HelloThereMatey/mag_sputter_tool/auto_control/docs/pics/bulb_off.png

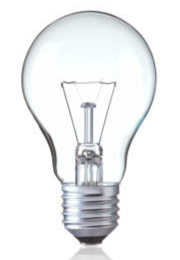
auto_control/docs/pics/bulb_off.png
