HelloThereMatey/mag_sputter_tool/auto_control/docs/pics/bulb_on.png

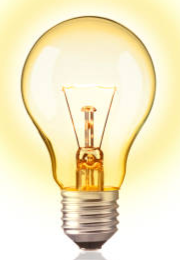
auto_control/docs/pics/bulb_on.png
