HelloThereMatey/mag_sputter_tool/auto_control/docs/pics/shutter.png

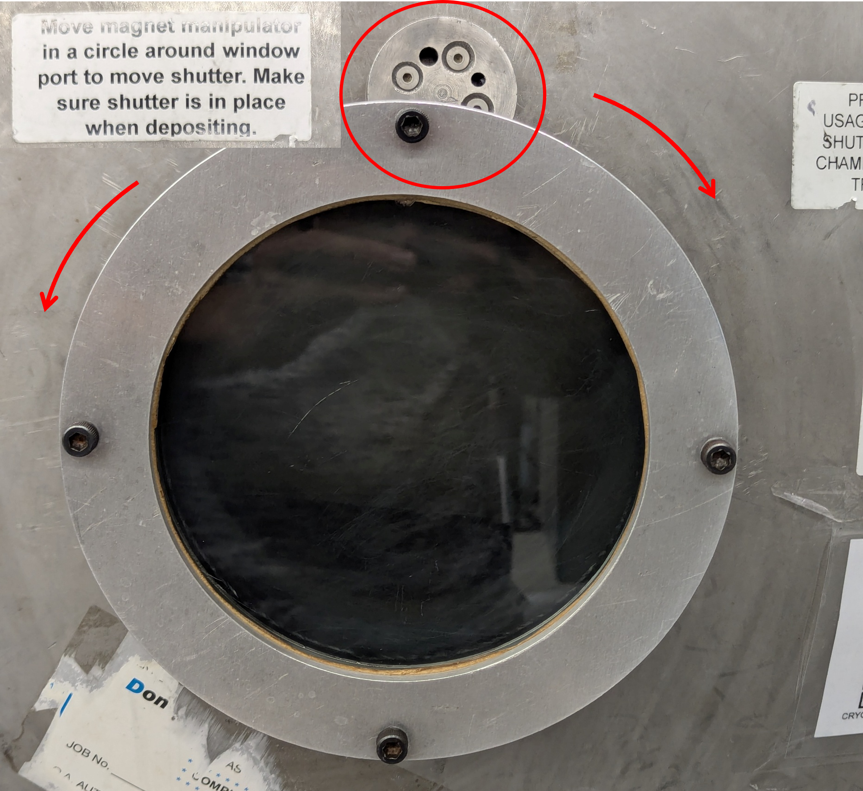
auto_control/docs/pics/shutter.png
