HelloThereMatey/mag_sputter_tool/launcher/sun.png

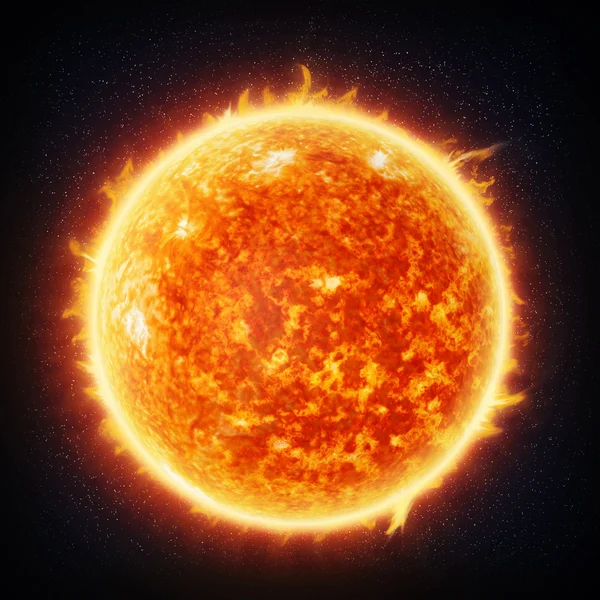
launcher/sun.png
