HelloThereMatey/mag_sputter_tool/pics/20251017_16h33m43s_grim.png

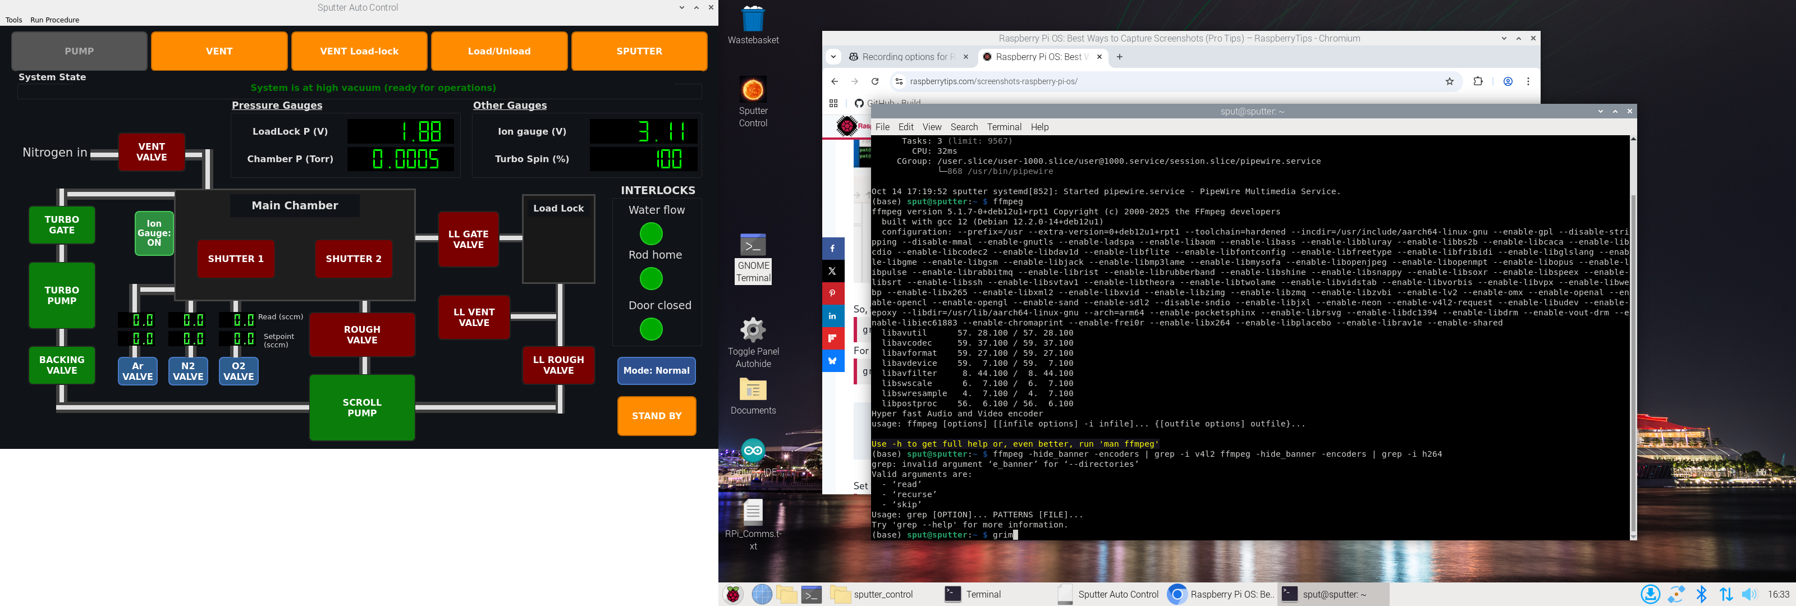
pics/20251017_16h33m43s_grim.png
