HelloThereMatey/mag_sputter_tool/pics/20251017_16h39m33s_grim.png

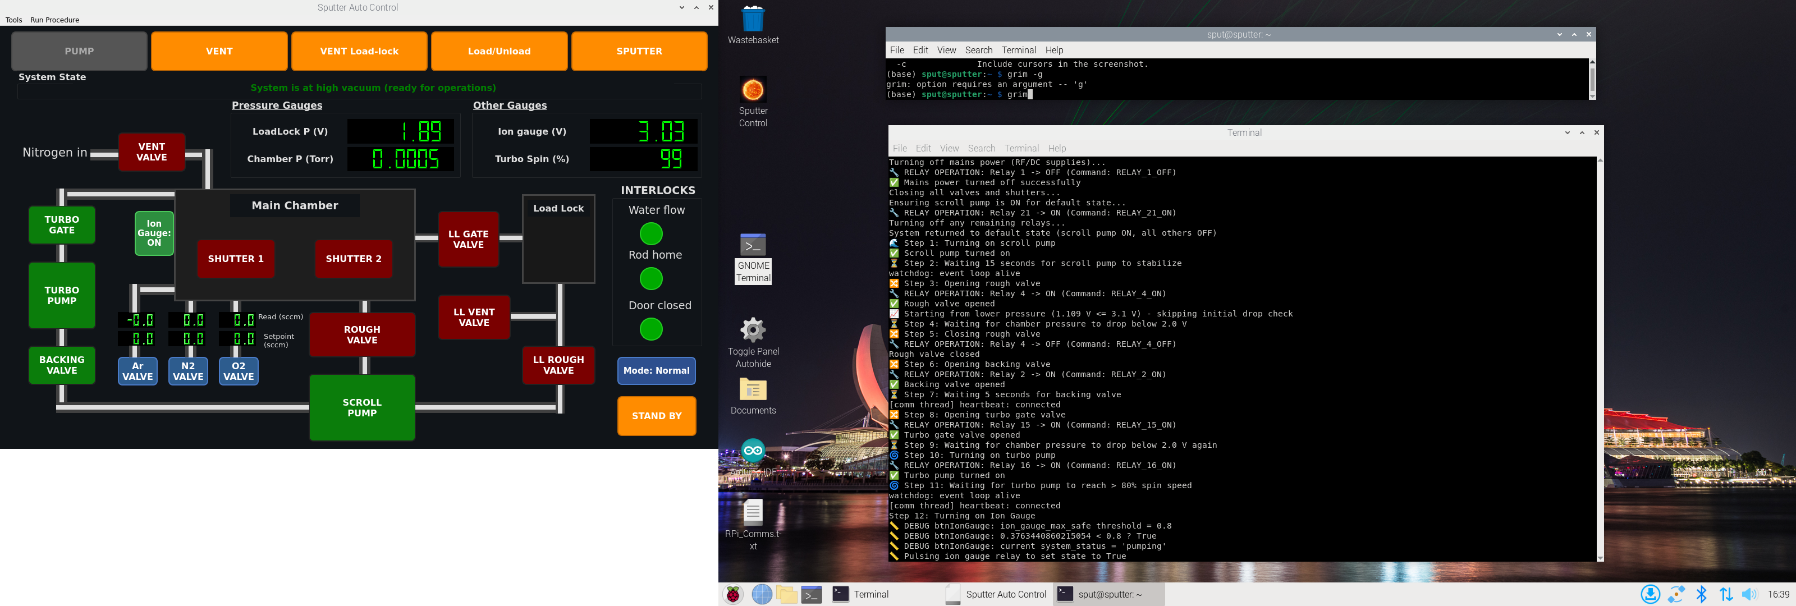
pics/20251017_16h39m33s_grim.png
