HelloThereMatey/mag_sputter_tool/pics/20251112_18h08m32s_grim.png

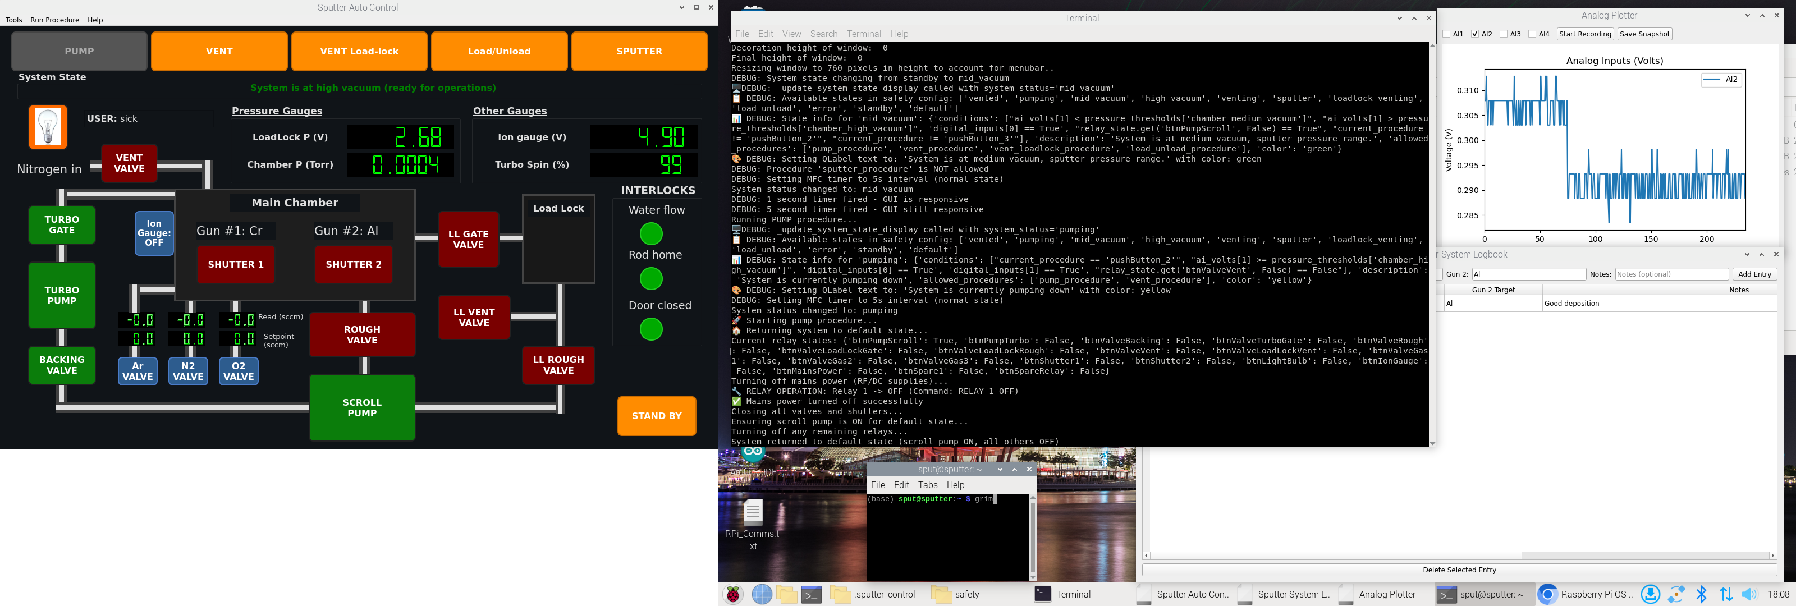
pics/20251112_18h08m32s_grim.png
