HelloThereMatey/mag_sputter_tool/pics/pump_water.jpg

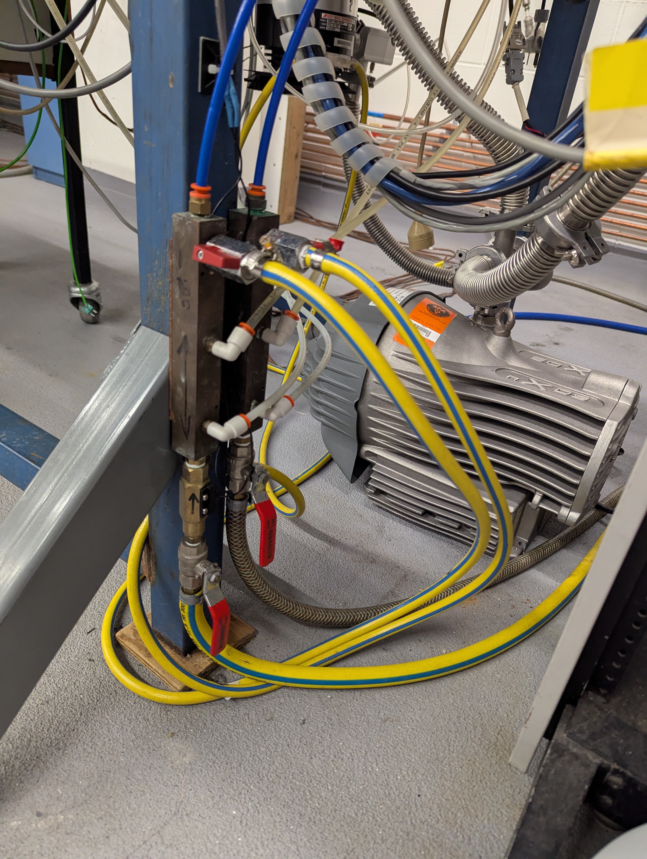
pics/pump_water.jpg
