HelloThereMatey/mag_sputter_tool/pics/pumpz.jpg

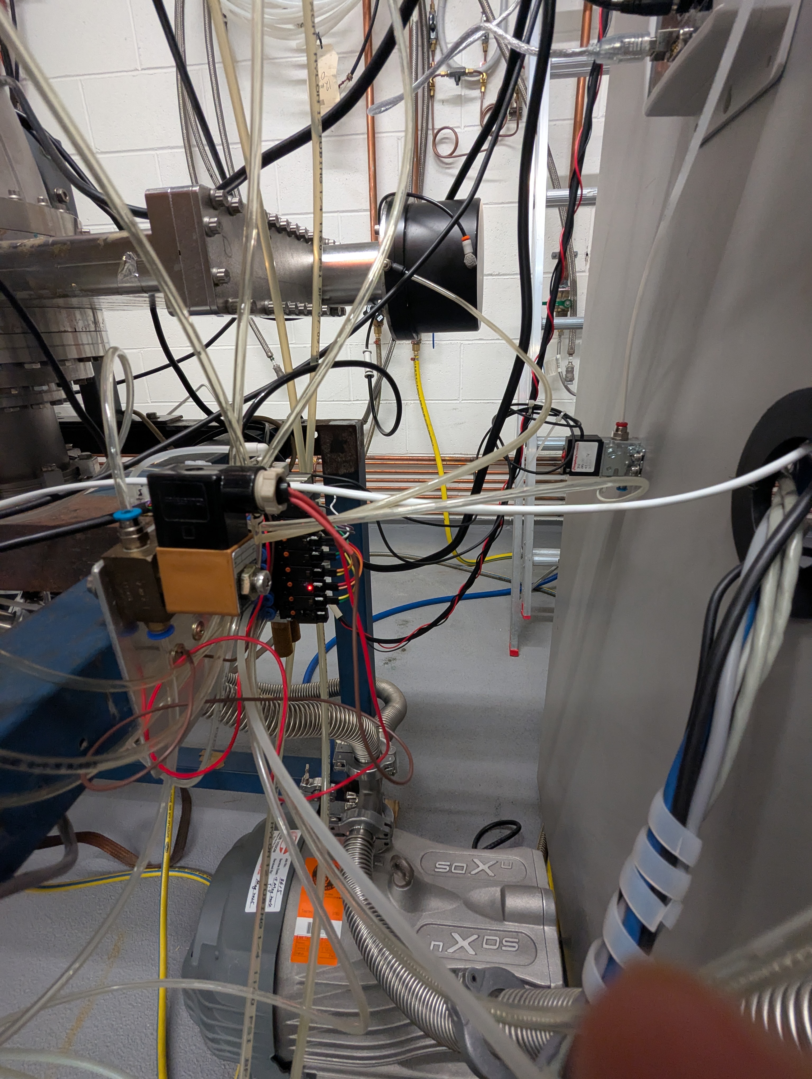
pics/pumpz.jpg
