HelloThereMatey/mag_sputter_tool/pics/PXL_20250912_063716222.jpg

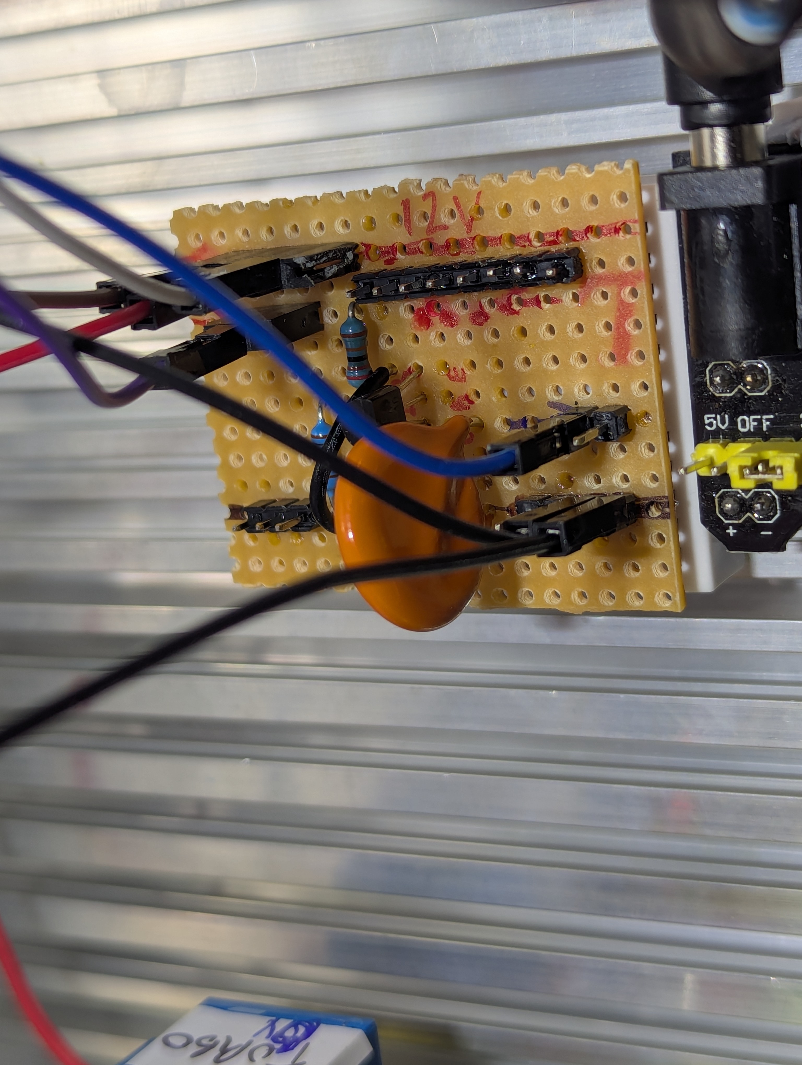
pics/PXL_20250912_063716222.jpg
