HelloThereMatey/mag_sputter_tool/pics/PXL_20250912_063729227.jpg

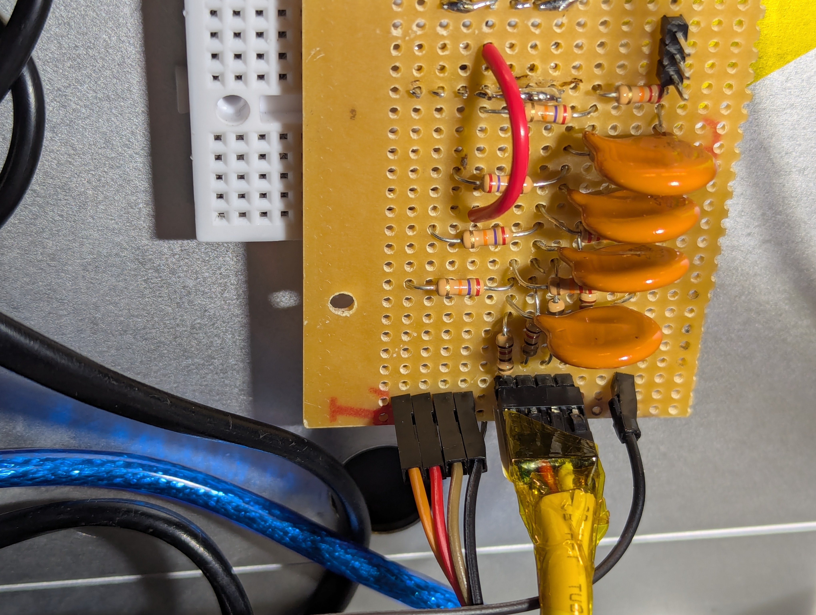
pics/PXL_20250912_063729227.jpg
