HelloThereMatey/mag_sputter_tool/pics/PXL_20251024_043526031.jpg

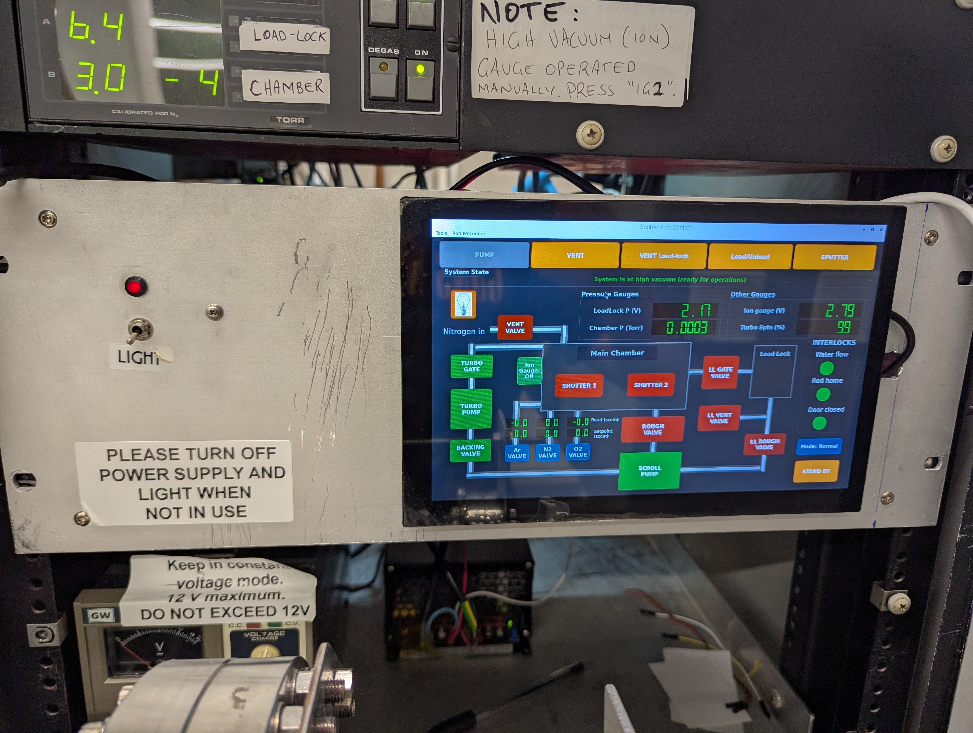
pics/PXL_20251024_043526031.jpg
