HelloThereMatey/mag_sputter_tool/pics/PXL_20251024_043535404.jpg

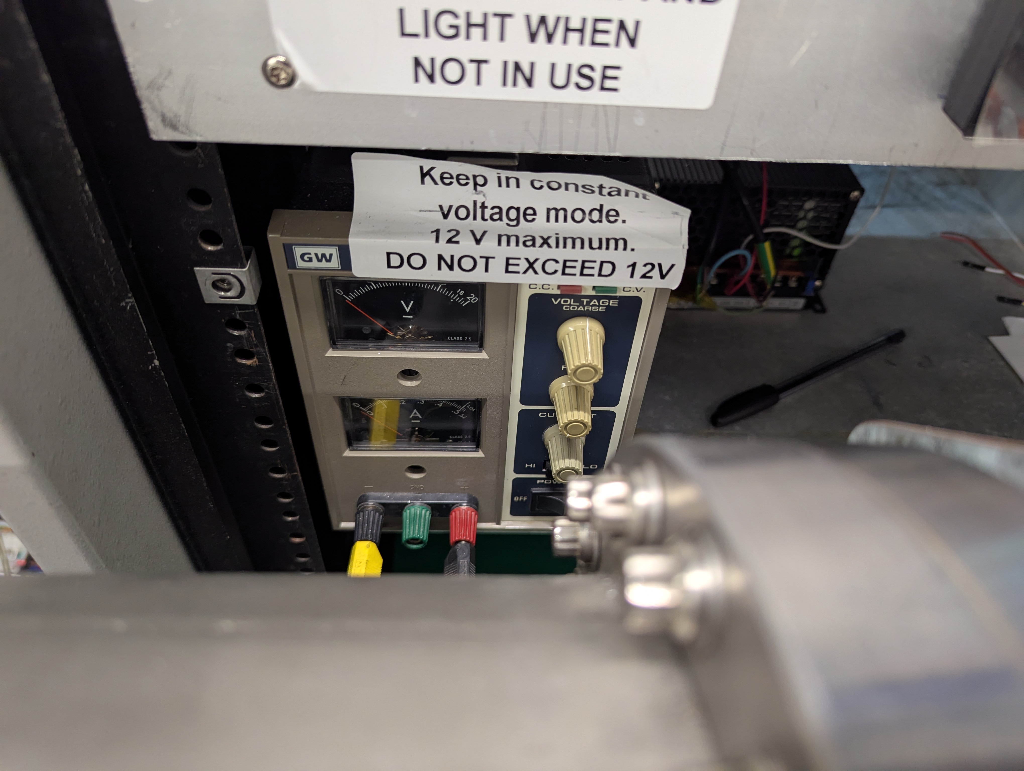
pics/PXL_20251024_043535404.jpg
