HelloThereMatey/mag_sputter_tool/pics/PXL_20251112_060554242.jpg

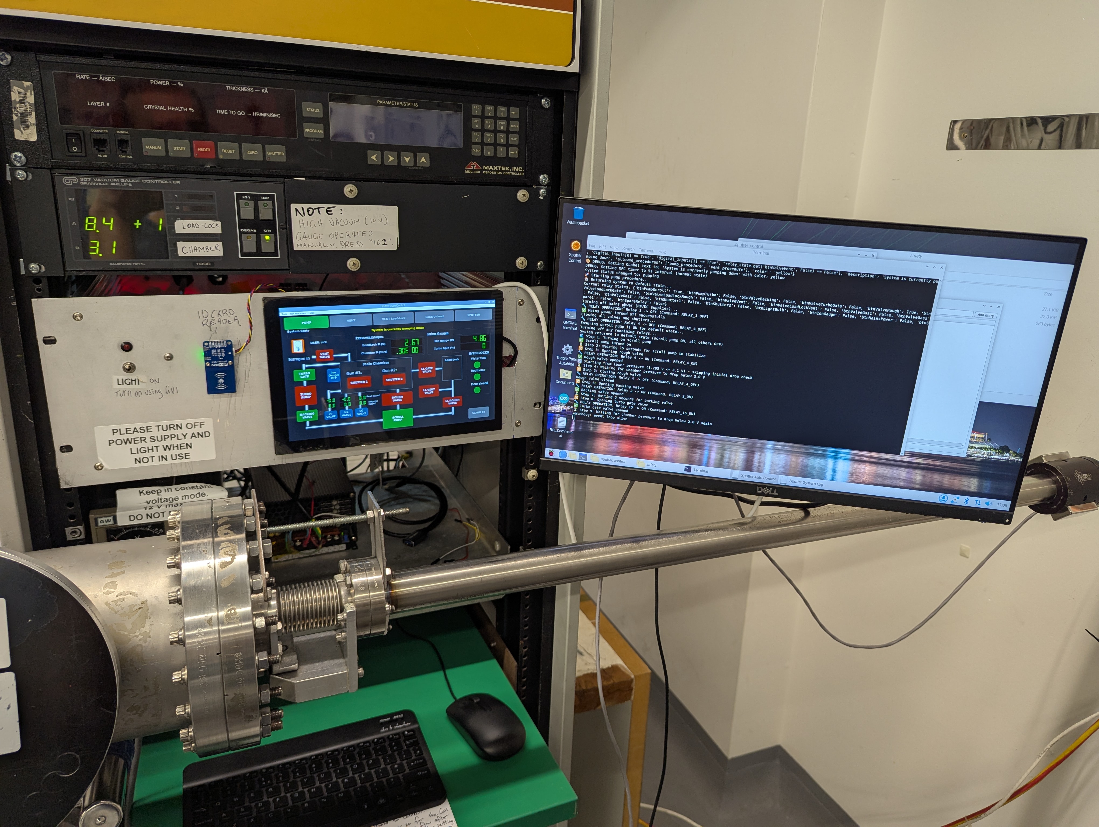
pics/PXL_20251112_060554242.jpg
