HelloThereMatey/mag_sputter_tool/pics/PXL_20251112_060644361.jpg

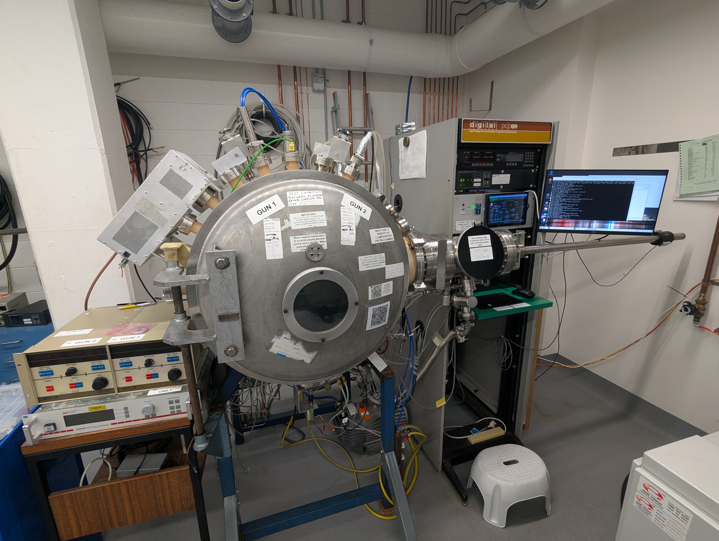
pics/PXL_20251112_060644361.jpg
