HelloThereMatey/mag_sputter_tool/pics/small/20251017_16h33m43s_grim.jpg

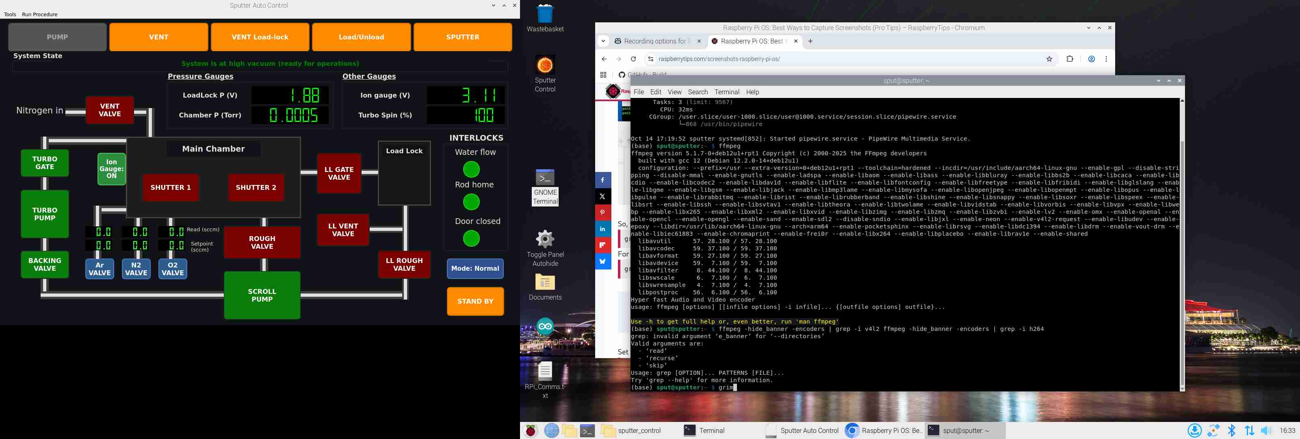
pics/small/20251017_16h33m43s_grim.jpg
