HelloThereMatey/mag_sputter_tool/pics/small/20251017_16h39m33s_grim.jpg

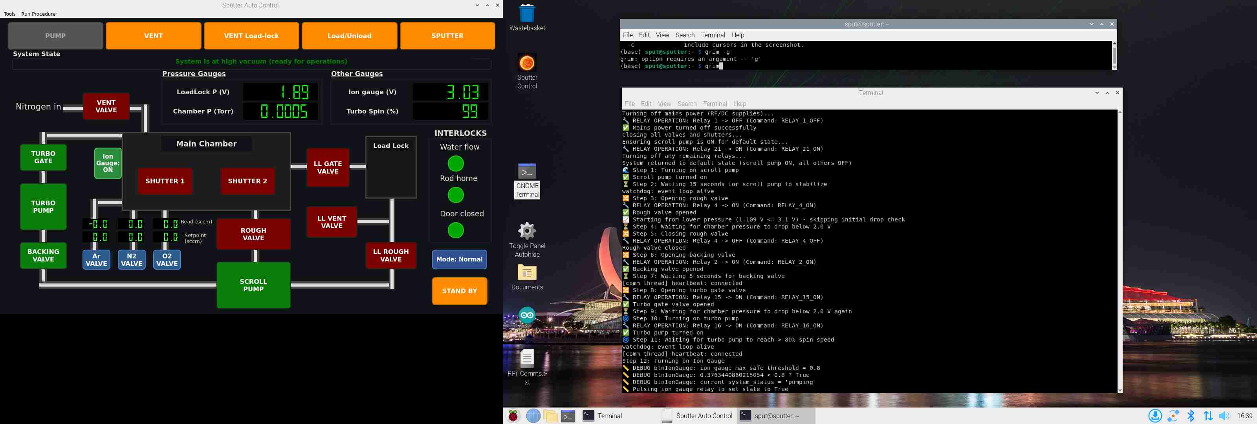
pics/small/20251017_16h39m33s_grim.jpg
