HelloThereMatey/mag_sputter_tool/pics/small/20251112_18h08m32s_grim.jpg

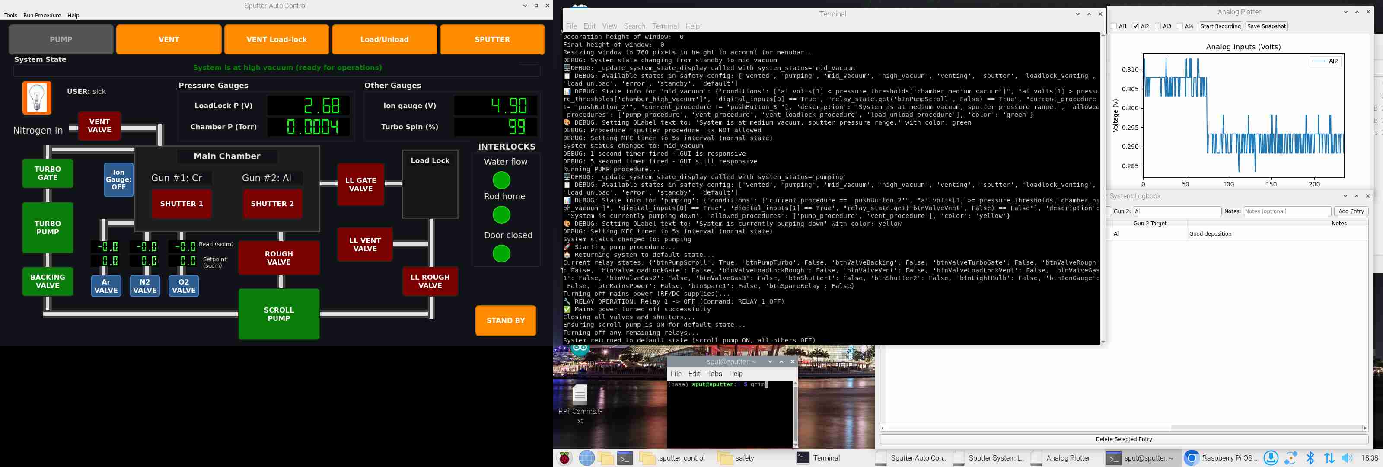
pics/small/20251112_18h08m32s_grim.jpg
