HelloThereMatey/mag_sputter_tool/auto_control/changes_needed.md

# Changes to make:

- Illumination active during while load-unload procedure. Ignore 30s rule during load-unload.
