HelloThereMatey/mag_sputter_tool/auto_control/python/tests/test_enhanced_output.py

#!/usr/bin/env python3
"""
Test Enhanced Terminal Output with Unicode Glyphs and Icons
===========================================================

This script demonstrates the enhanced terminal output with Unicode glyphs
and icons that we've added throughout the sputter control system.
"""

def test_enhanced_output():
    """Test various enhanced print statements with Unicode glyphs."""
    
    print("🚀 Testing Enhanced Terminal Output with Unicode Glyphs!")
    print("=" * 60)
    
    # System States & Procedures
    print("\n🔧 System States & Procedures:")
    print("🚀 Procedure starting")
    print("✅ Success/completion") 
    print("❌ Error/failure")
    print("⚠️ Warning")
    print("🛑 Cancellation/stop/abort")
    print("🔧 System configuration/setup")
    print("🏠 Default state operations")
    print("😴 Standby operations")
    print("🌊 Pumping operations")
    print("💨 Venting operations")
    print("🔄 Load/unload operations")
    print("⚡ Electrical/power operations")
    print("🌟 Special features/gas valve override")
    
    # Hardware Components
    print("\n🎛️ Hardware Components:")
    print("🔌 Connection/Arduino operations")
    print("📊 Status/monitoring")
    print("🔘 Digital inputs/interlocks")
    print("📈 Analog inputs/sensors")
    print("🎛️ Relay operations")
    print("💧 Water cooling")
    print("🚪 Door operations")
    print("🌀 Turbo pump operations")
    print("📏 Ion gauge operations")
    print("🕳️ Vacuum operations")
    print("🔀 Valve operations")
    print("🧹 Cleanup operations")
    
    # Debug & Development
    print("\n🔍 Debug & Development:")
    print("🐛 Debug messages")
    print("🔍 Search/discovery")
    print("📝 Data/information")
    print("📨 Communication/messages")
    print("⏳ Waiting/timing")
    print("🎯 Testing/validation")
    
    # User Interface
    print("\n🖱️ User Interface:")
    print("🖱️ User interaction")
    print("💬 Dialog/UI operations")
    print("🎨 Display updates")
    print("⌨️ Input/focus")
    
    # Procedure Step Examples
    print("\n🌊 Procedure Step Examples:")
    print("🌊 Step 1: Turning on scroll pump")
    print("⏳ Step 2: Waiting 15 seconds for scroll pump to stabilize")
    print("🔀 Step 3: Opening rough valve")
    print("⏳ Step 4: Waiting for chamber pressure to drop below 2.0 V")
    print("🔀 Step 5: Closing rough valve")
    print("🔀 Step 6: Opening backing valve")
    print("⏳ Step 7: Waiting 5 seconds for backing valve")
    print("🔀 Step 8: Opening turbo gate valve")
    print("🌀 Step 10: Turning on turbo pump")
    print("🌀 Step 11: Waiting for turbo pump to reach > 80% spin speed")
    print("📏 Step 12: Turning on Ion Gauge")
    print("✅ Pump procedure completed successfully!")
    
    # Status Messages
    print("\n📊 Status Messages:")
    print("📈 Starting from atmospheric pressure (3.1 V)")
    print("🔍 Performing initial pressure drop check to detect door leaks...")
    print("✅ Pressure has begun to drop after opening rough valve; continuing pump procedure.")
    print("⏰ Timeout waiting for chamber pressure to drop")
    print("🚨 Abort: Chamber pressure did not begin to drop within 25s")
    print("⚠️ Warning: could not read baseline chamber pressure - skipping initial drop check")
    
    # Safety & Debug Messages
    print("\n🔒 Safety & Debug Messages:")
    print("⚠️ Safety check failed for btnPumpScroll: Interlocks not satisfied")
    print("🐛 DEBUG: Arduino controller assigned, connected: True")
    print("🔌 DEBUG: on_connected() - Arduino connection established")
    print("🐛 DEBUG: Setting procedure state override: 'pump_procedure' -> 'pumping'")
    print("📏 DEBUG btnIonGauge: ion_gauge_max_safe threshold = 0.7")
    print("🌟 Gas valves are now available for manual control during sputter procedure")
    
    # Hardware Status
    print("\n🎛️ Hardware Status:")
    print("🔌 Connected successfully!")
    print("🌀 Turbo pump turned on")
    print("📏 Ion gauge already in desired state (True)")
    print("🔀 Backing valve opened")
    print("💧 Water cooling: OK")
    print("🚪 Door: OK")
    print("🔘 Digital Inputs (Safety Interlocks):")
    print("   💧 Water: SAFE")
    print("   🚪 Door: SAFE") 
    print("   🔧 Rod: SAFE")
    
    print("\n🎉 Enhanced terminal output test completed!")
    print("Your terminal should now display beautiful Unicode glyphs and icons! 🌈")

if __name__ == "__main__":
    test_enhanced_output()
