HelloThereMatey/mag_sputter_tool/relay_test_system/python/setup_test.py

"""
Setup and Test Script for Relay Test System
Cross-platform compatibility for Windows, Linux, and Raspberry Pi
Checks dependencies, tests basic functionality, and provides setup guidance
"""

import sys
import importlib.util
import platform

def check_python_version():
    """Check if Python version is compatible."""
    if sys.version_info < (3.7, 0):
        print("❌ Python 3.7 or higher is required")
        print(f"   Current version: {sys.version}")
        return False
    else:
        print(f"✅ Python version: {sys.version.split()[0]}")
        return True

def check_dependencies():
    """Check if required dependencies are installed."""
    dependencies = {
    'PyQt5': 'PyQt5',
        'serial': 'pyserial'
    }
    
    missing = []
    
    for import_name, package_name in dependencies.items():
        try:
            importlib.import_module(import_name)
            print(f"✅ {package_name} is installed")
        except ImportError:
            print(f"❌ {package_name} is NOT installed")
            missing.append(package_name)
    
    return missing

def check_serial_ports():
    """Check available serial ports with platform-specific guidance."""
    try:
        import serial.tools.list_ports
        ports = list(serial.tools.list_ports.comports())
        
        current_platform = platform.system().lower()
        
        if ports:
            print(f"\n✅ Found {len(ports)} serial port(s):")
            for port in ports:
                description = port.description
                if hasattr(port, 'manufacturer') and port.manufacturer:
                    description += f" ({port.manufacturer})"
                print(f"   {port.device} - {description}")
                
                # Platform-specific hints
                device_lower = port.device.lower()
                if current_platform == "linux":
                    if "/dev/ttyacm" in device_lower:
                        print("     💡 Likely Arduino (ACM device)")
                    elif "/dev/ttyusb" in device_lower:
                        print("     💡 Likely USB serial (Arduino clone)")
        else:
            print("\n⚠️  No serial ports found")
            if current_platform == "linux":
                print("   💡 Linux users:")
                print("     - Check USB connection: lsusb")
                print("     - Add user to dialout group: sudo usermod -a -G dialout $USER")
                print("     - Logout and login again")
                print("     - Check for devices: ls -la /dev/tty* | grep -E '(ACM|USB)'")
            elif current_platform == "windows":
                print("   💡 Windows users:")
                print("     - Check Device Manager for COM ports")
                print("     - Install Arduino drivers if needed")
            print("   Make sure Arduino is connected via USB")
        
        return len(ports) > 0
    except ImportError:
        print("\n❌ Cannot check serial ports (pyserial not installed)")
        return False

def test_basic_imports():
    """Test basic imports to catch any issues."""
    try:
        # Test Arduino controller import
        from arduino_controller import ArduinoController
        print("✅ Arduino controller module loads correctly")
        
        # Test GUI import
        from gui import RelayTestWindow
        print("✅ GUI module loads correctly")
        
        return True
    except ImportError as e:
        print(f"❌ Import error: {e}")
        return False
    except Exception as e:
        print(f"❌ Other error: {e}")
        return False
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
