HelloThereMatey/mag_sputter_tool/(commit log)

2025-11-04 First commit. Magnetron sputter system. Python based GUI control system for Rpi5-Arduino hardware.
    [Connectors.xlsx]
2025-12-02 probs with too much resource cons
    [app.py, auto_procedures.py, config.py, safety_conditions.yml, subprocess_controller.py, test_gas_control.py]
2026-03-05 Fix UI thread safety issues and RFID port connection
    [logbook.csv]
